Laikata/Design/Diseño Mecanico Final Laikata v.1.0/README.txt

DOCUMENTO INFORMATIVO DISEÑO MECÁNICO LAIKATA
v.1.0

---IMPRESIÓN---
	
	*Barra Mecanismo Motor x1
	*Carcasa x1
	*Plataforma Interna Con Agujero Baterias x1
	*Plataforma Interna Sin Agujero Baterias x2
	*Separador 1 x3
	*Separador 2 x3
	*Separador 3 x3
	*Separador 4 x3
	*Separador 5 x3
	*Soporte Mecanismo Motor x1
	*Soporte Motor x1
	*Tapa x1

---UTILIDAD---
	
	-Barra Mecanismo Motor:				Esta barra servira como guia y soporte del mecanismo de extracción del motor.

	-Carcasa:						Esta es la carcasa del Laikata donde se encontraran todos los sistemas internos de la misma, esta probablemente tendrá que ser modificada en un futuro para integrar la entrada de los puertos de la placa.

	-Plataforma Interna Con Agujero Baterias:	En esta plataforma se encontrarán el mecanismo de expulsión del motor y tendrá un agujero para las baterias puedan entrar en la lata.

	-Plataforma Interna Sin Agujero Baterias:	Esta plataforma servirá como limite superior e inferior del movimiento libre de las baterias y tambien como limite de giro del mecanismo del motor.

	-Separador 1:					Primer separador de la lata yendo de abajo hacia arriba.

	-Separador 2:					Segundo separador de la lata yendo de abajo hacia arriba.

	-Separador 3:					Tercero separador de la lata yendo de abajo hacia arriba.

	-Separador 4:					Cuarto separador de la lata yendo de abajo hacia arriba.

	-Separador 5:					Quinto separador de la lata yendo de abajo hacia arriba.

	-Soporte Mecanismo Motor:			Este soporte conecta el servomotor con el mecanismo de extracción del motor y también sirve como guia para el mismo y la barra.

	-Soporte Motor:					Conecta la barra con el motor.

	-Tapa:						La tapa servirá para cerrar el Laikata y como punto de anclaje del paracaidas.
