Laikata/Design/PresupuestoLaikata2023.ods

Presupuesto componentes Laikata
Unidad | Descripción | Coste unitario | Cantidad | Coste total | Peso Unitario | Peso Total
Microcontroladores |  |  | 1
Nano rp2040 | RP2040 | 28,95 € | 1 | 28,95 € | 7,00 g | 7,00 g
Sensores
NEOGPS | GPS | 22,87 € | 1 | 22,87 €
BNO055 | Inercial ABS | 40,54 € | 1 | 40,54 €
BMP280 | Presión | 2,95 € | 1 | 2,95 € | 7,00 g | 7,00 g
Actuadores
Motor | TOKA 1103 | 12,99 € | 1 | 12,99 €
SG90 | Servo | 2,96 € | 1 | 2,96 € | 7,00 g | 7,00 g
HC12 | Módulo Radio | 8,00 € | 2 | 16,00 € | 5,00 g | 10,00 g
Sistemas de alimentación |  |  |  | 0,00 €
Batería Lipo | 1100mAh | 7,87 € | 2 | 15,74 € | 12,00 g | 24,00 g
Regulador | 3.3V | 1,00 € | 1 | 1,00 € | 7,00 g | 7,00 g
ESC | Driver 20A | 13,50 € | 1 | 13,50 €
Regulador | 5V | 1,00 € | 1 | 1,00 € | 6,00 g | 6,00 g
Componentes electrónicos discretos
Placas PCB |  | 1,00 € | 2 | 2,00 € | 10,00 g | 20,00 g
Componentes | Varios | 20,00 € | 1 | 20,00 € | 5,00 g | 5,00 g
Estructura
Nylon impermeable | Paracaídas | 15,00 € | 1 | 15,00 € | 15,00 g | 15,00 g
Dyneema 1mm | Cuerda | 0,20 € | 5 | 1,00 € | 0,90 g | 4,50 g
Carcasa exterior | PLA |  | 1 | 2,00 € | 70,00 g | 70,00 g
Separadores |  |  | 4 | 0,00 € | 3,00 g | 12,00 g
Tornillería |  | 1,00 € | 2 | 2,00 € | 5,00 g | 10,00 g
 |  |  | Total | 200,50 € | Total | 204,5
 |  |  | Laikata € | 40,10 % | Laikata peso | 58,43 %
