Laikata/Design/Diseño Mecanico Final Laikata v.1.0/Separador 2.obj

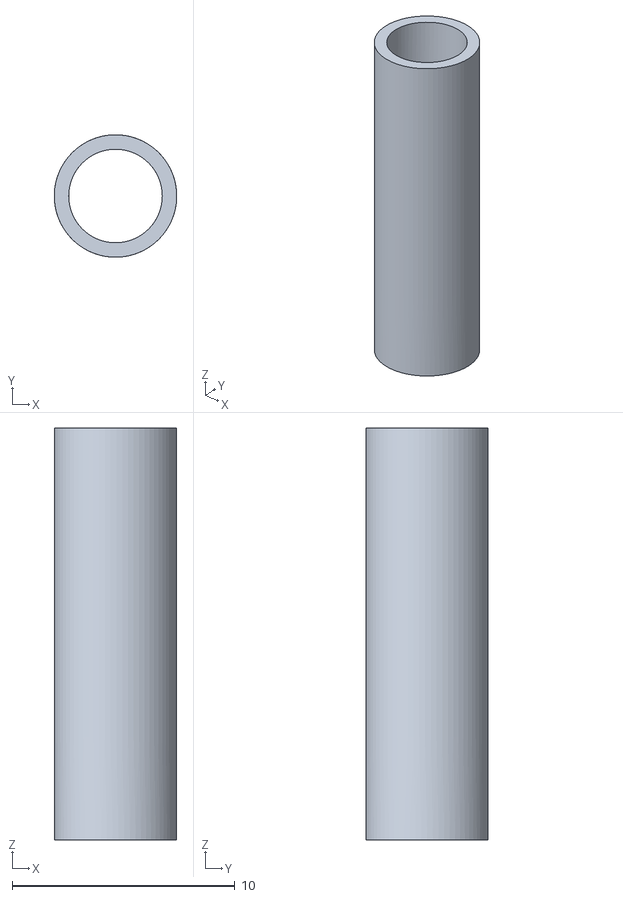
[picture p17: CAD file, 2023-04-25]
Diseño Mecanico Final Laikata v.1.0/Separador 2.obj
5.50 x 5.50 x 18.5
