Laikata/Design/Diseño Mecanico Final Laikata v.1.0/Soporte Mecanismo Motor.obj

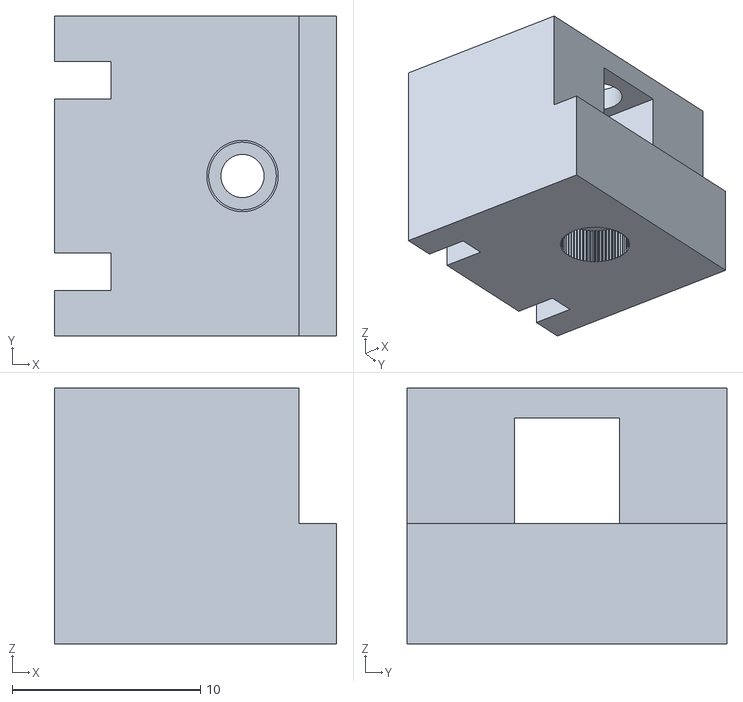
[picture p18: CAD file, 2023-04-25]
Diseño Mecanico Final Laikata v.1.0/Soporte Mecanismo Motor.obj
15.0 x 17.0 x 13.6
