Laikata/Design/Diseño Mecanico Final Laikata v.1.0/Separador 3.obj

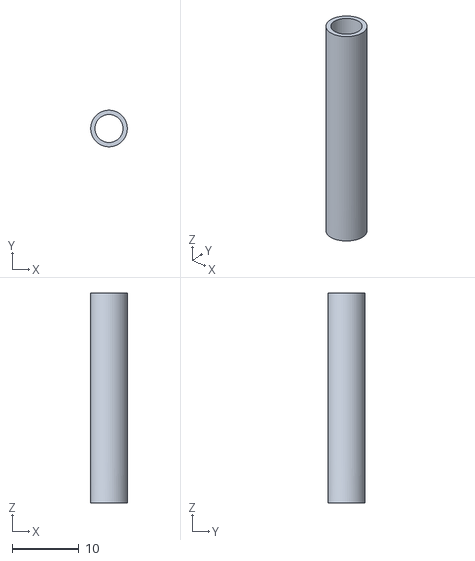
[picture p19: CAD file, 2023-04-25]
Diseño Mecanico Final Laikata v.1.0/Separador 3.obj
5.50 x 5.50 x 31.5
