Laikata/Design/Diseño Mecanico Final Laikata v.1.0/Separador 4.obj

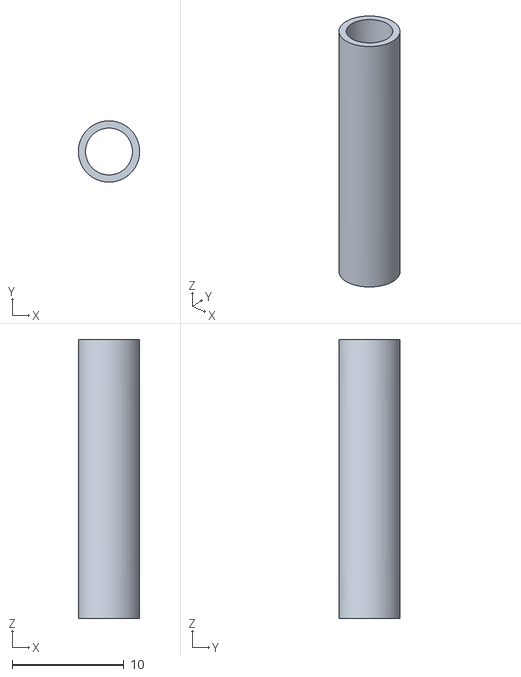
[picture p20: CAD file, 2023-04-25]
Diseño Mecanico Final Laikata v.1.0/Separador 4.obj
5.50 x 5.50 x 25.0
