Laikata/Design/Diseño Mecanico Final Laikata v.1.0/Separador 5.obj

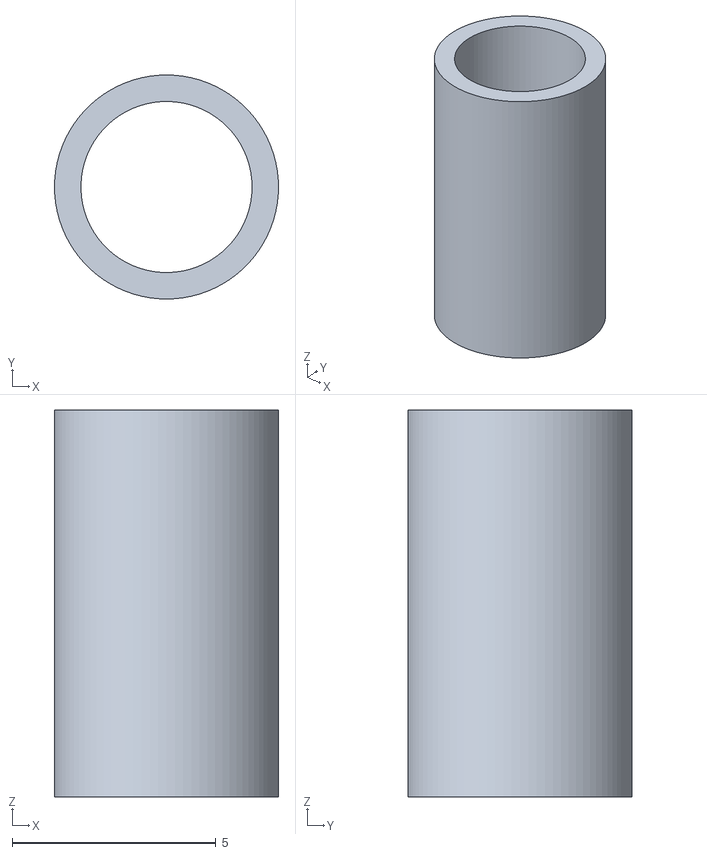
[picture p21: CAD file, 2023-04-25]
Diseño Mecanico Final Laikata v.1.0/Separador 5.obj
5.50 x 5.50 x 9.50
