Laikata/Design/Diseño Mecanico Final Laikata v.1.0/Barra Mecanismo Motor.obj

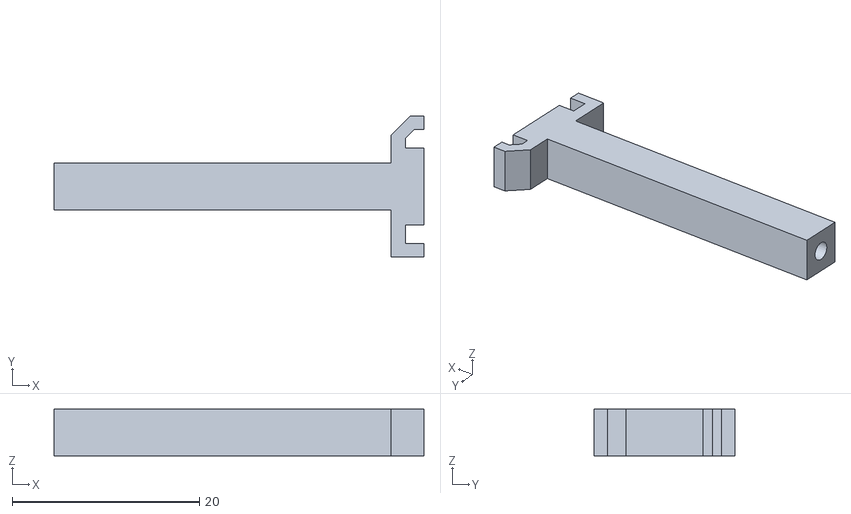
[picture p23: CAD file, 2023-04-25]
Diseño Mecanico Final Laikata v.1.0/Barra Mecanismo Motor.obj
39.5 x 15.0 x 5.00
