Laikata/Design/Diseño Mecanico Final Laikata v.1.0/Soporte Motor.obj

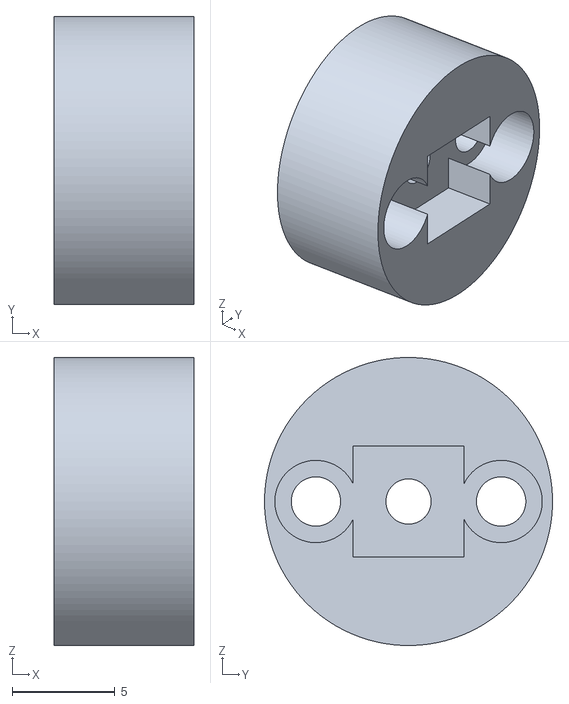
[picture p24: CAD file, 2023-04-25]
Diseño Mecanico Final Laikata v.1.0/Soporte Motor.obj
6.80 x 14.0 x 14.0
