Laikata/Design/Diseño Mecanico Final Laikata v.1.0/Plataforma Interna Con Agujero Baterias.obj

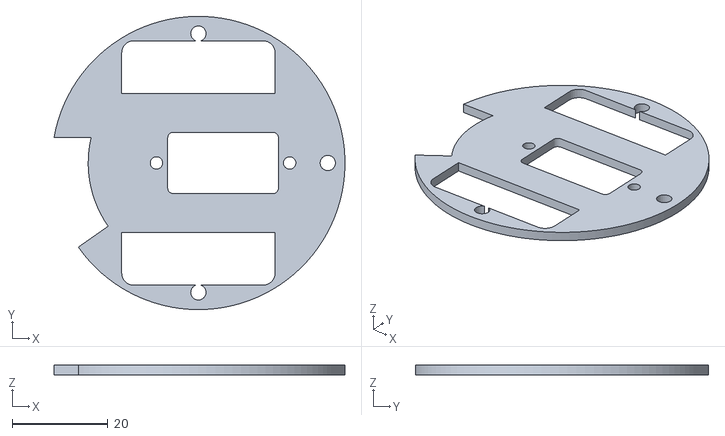
[picture p25: CAD file, 2023-04-25]
Diseño Mecanico Final Laikata v.1.0/Plataforma Interna Con Agujero Baterias.obj
60.7 x 61.2 x 2.00
