Laikata/Design/Diseño Mecanico Final Laikata v.1.0/Carcasa.obj

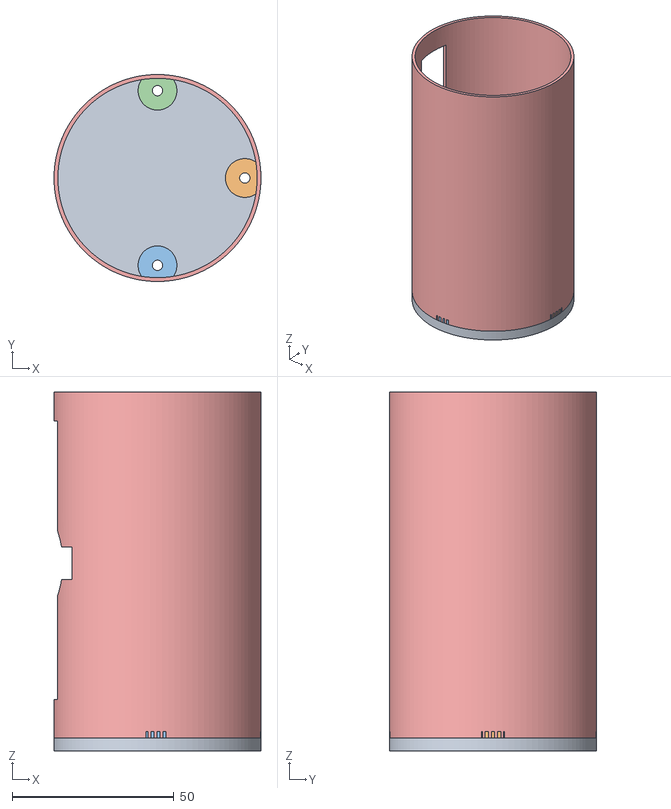
[picture p26: CAD file, 2023-04-25]
Diseño Mecanico Final Laikata v.1.0/Carcasa.obj
64.0 x 64.0 x 111.0
Cuerpo1
Cuerpo4
Cuerpo2
Cuerpo3
Cuerpo3:1
