Laikata/Design/Diseño Mecanico Final Laikata v.1.0/Tapa.obj

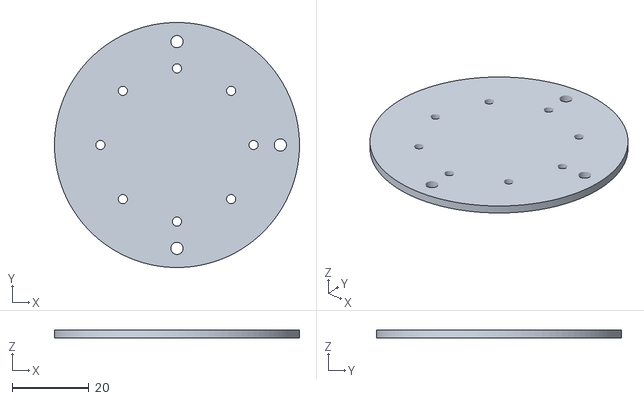
[picture p27: CAD file, 2023-04-25]
Diseño Mecanico Final Laikata v.1.0/Tapa.obj
64.0 x 64.0 x 2.00
