Laikata/Design/Diseño Mecanico Final Laikata v.1.0/Separador 1.obj

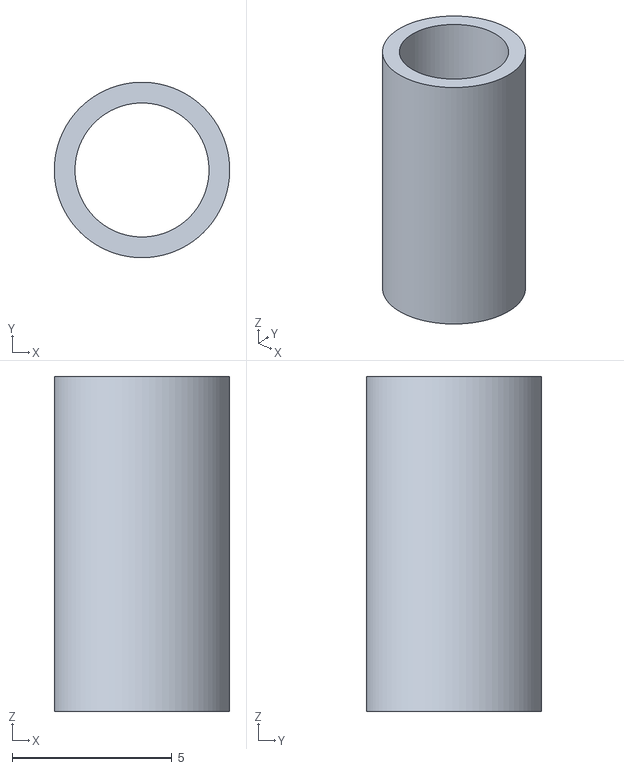
[picture p28: CAD file, 2023-04-25]
Diseño Mecanico Final Laikata v.1.0/Separador 1.obj
5.50 x 5.50 x 10.5
