Laikata/Design/(threads)

Thread 2 (2023-02-09):

Paracaídas

Arnau478, 2023-02-09:
- [x] Diseño
  - [x] Elegir el tipo de paracaídas óptimo
  - [x] Diseñar las piezas de tela
  - [x] Determinar la tela y cuerda a utilizar
- [ ] Construcción
  - [x] Cortar piezas de tela
  - [ ] Coser las piezas de tela
  - [ ] Coser las cuerdas
- [ ] Puebas
  - [ ] Debe aguantar 50N
  - [ ] Debe relentizar un peso de 350g a una velocidad de aproximadamente 10m/s
