Laikata/Design/Laikata/Laikata.brd

## EAGLE design Laikata/Laikata.brd (2023-03-20)

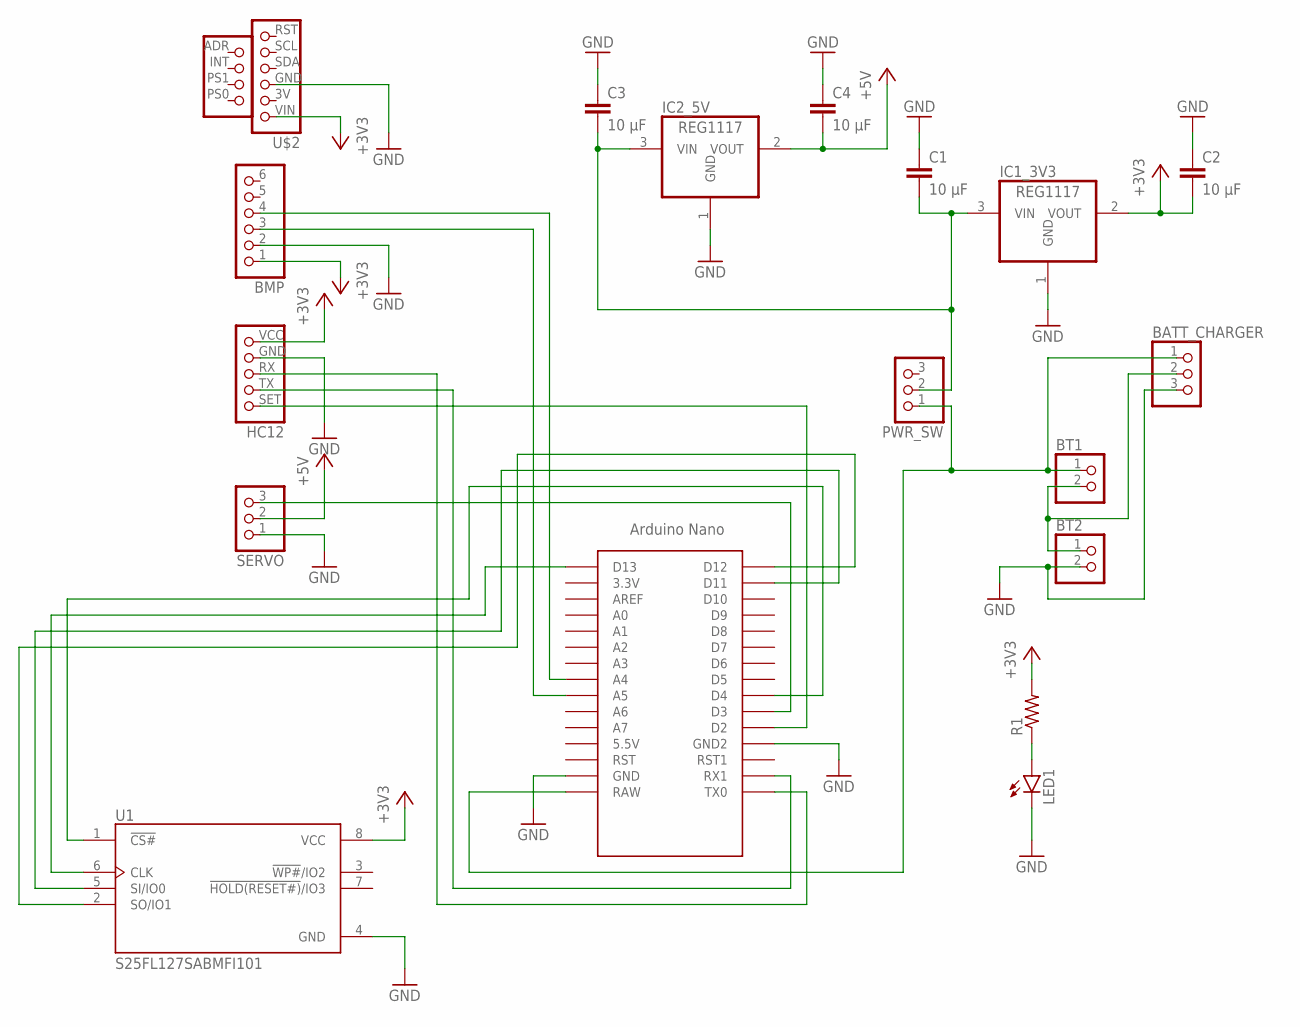
[picture p31: schematic Laikata.sch]

Parts:
BATT_CHARGER: PINHD-1X3; 1X03
BMP: PINHD-1X6; 1X06
BT1, BT2: PINHD-1X2; 1X02
C1, C2, C3, C4: 10 μF; C1210
HC12: HC12
IC1_3V3, IC2_5V: REG1117; SOT223
LED1: LED3MM
PWR_SW: PINHD-1X3; 1X03
R1: R-US_R1206; R1206
SERVO: PINHD-1X3; 1X03
U1: S25FL127SABMFI101; SOIC127P800X216-8N
U$1: NANO
U$2: IMU

Connections:
+3V3: BMP.1, C2.2, HC12.VCC, IC1_3V3.2 (VOUT), R1.2, U1.8 (VCC), U$2.VIN
+5V: C4.2, IC2_5V.2 (VOUT), SERVO.2
GND: BATT_CHARGER.3, BMP.2, BT2.2, C1.1, C2.1, C3.1, C4.1, HC12.GND, IC1_3V3.1 (GND), IC2_5V.1 (GND), LED1.K (C), SERVO.1, U1.4 (GND), U$1.GND, U$1.GND1 (GND2), U$2.GND
unnamed: BATT_CHARGER.1, BT1.1, PWR_SW.1, U$1.RAW
unnamed: C1.2, C3.2, IC1_3V3.3 (VIN), IC2_5V.3 (VIN), PWR_SW.2
unnamed: HC12.SET, U$1.D2
unnamed: HC12.TX, U$1.RX1
unnamed: HC12.RX, U$1.TX0
unnamed: SERVO.3, U$1.D3
unnamed: LED1.A, R1.1
unnamed: U1.1 (!CS#), U$1.D4
unnamed: U1.6 (CLK), U$1.D13
unnamed: U1.5 (SI/IO0), U$1.D11
unnamed: U1.2 (SO/IO1), U$1.D12
unnamed: BMP.3, U$1.A5
unnamed: BMP.4, U$1.A4
unnamed: BATT_CHARGER.2, BT1.2, BT2.1

Board: 2 copper layers, 18 parts (0 on the bottom side), 17 nets, no tracks yet.
