Laikata/Design/(commit log)

2023-03-20 PCB
    First commit
    [Laikata.brd, Laikata.sch]
2023-03-20 IMU component
    Created and added a custom component for the BNO055 sensor
    [Laikata.brd, Laikata.sch]
2023-03-23 CDR Parte Pepe
    He añadido mi parte del CDR donde se incluye el diseño mecánico
2023-03-23 CDR Yeray
    paracaidas y extension de varios apartados como la introduccion y plan de difusión
2023-03-28 Parte estacion de base
2023-03-29 Presupuesto
    El presupuesto provisional sin acabar
    [PresupuestoLaikata2023.ods]
2023-03-29 CDR Parte Pepe 2
    Añadido la nueva parte de Pepe del CDR
2023-03-29 CDRYeray v2
    add diagrama de flujos
2023-04-25 Se ha organizado el repositorio Design y se han añadido el diseño mecánico final y el CDR final.
    [Barra Mecanismo Motor.obj, Carcasa.obj, Plataforma Interna Con Agujero Baterias.obj, Plataforma Interna Sin Agujero Baterias.obj, Separador 1.obj, Separador 2.obj, Separador 3.obj, Separador 4.obj]
2023-04-25 Update README.txt
    Arreglos realizados en la maquetación del README.txt
